fancong888/harvester/data/6-Software part/0-Original materilas/微信图片_20220603220855.jpg

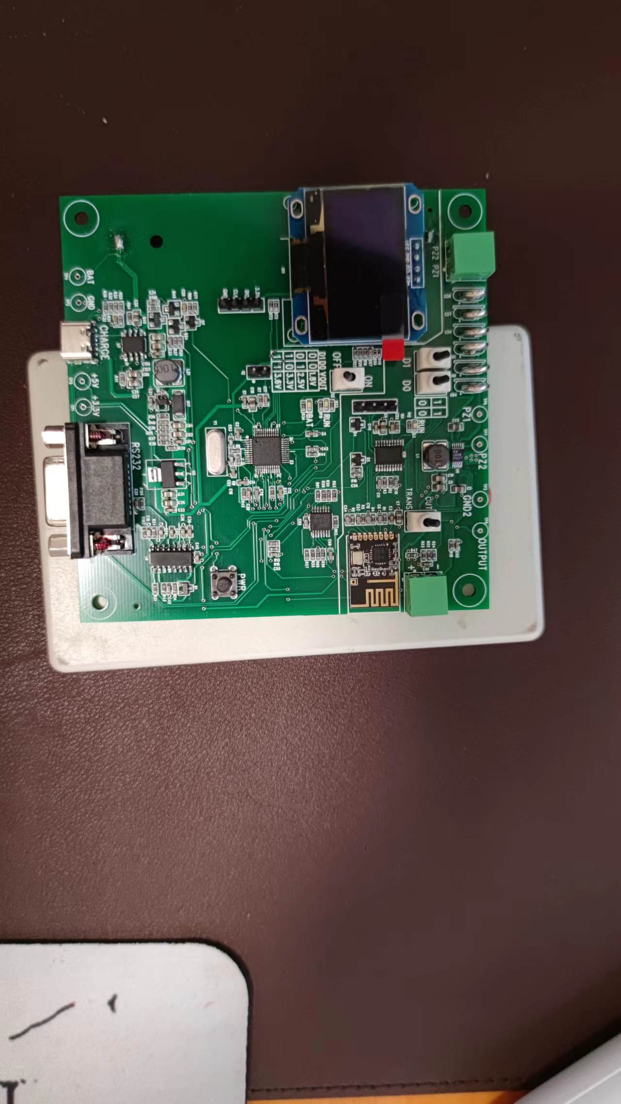
data/6-Software part/0-Original materilas/微信图片_20220603220855.jpg
