fancong888/harvester/data/Plan.pdf

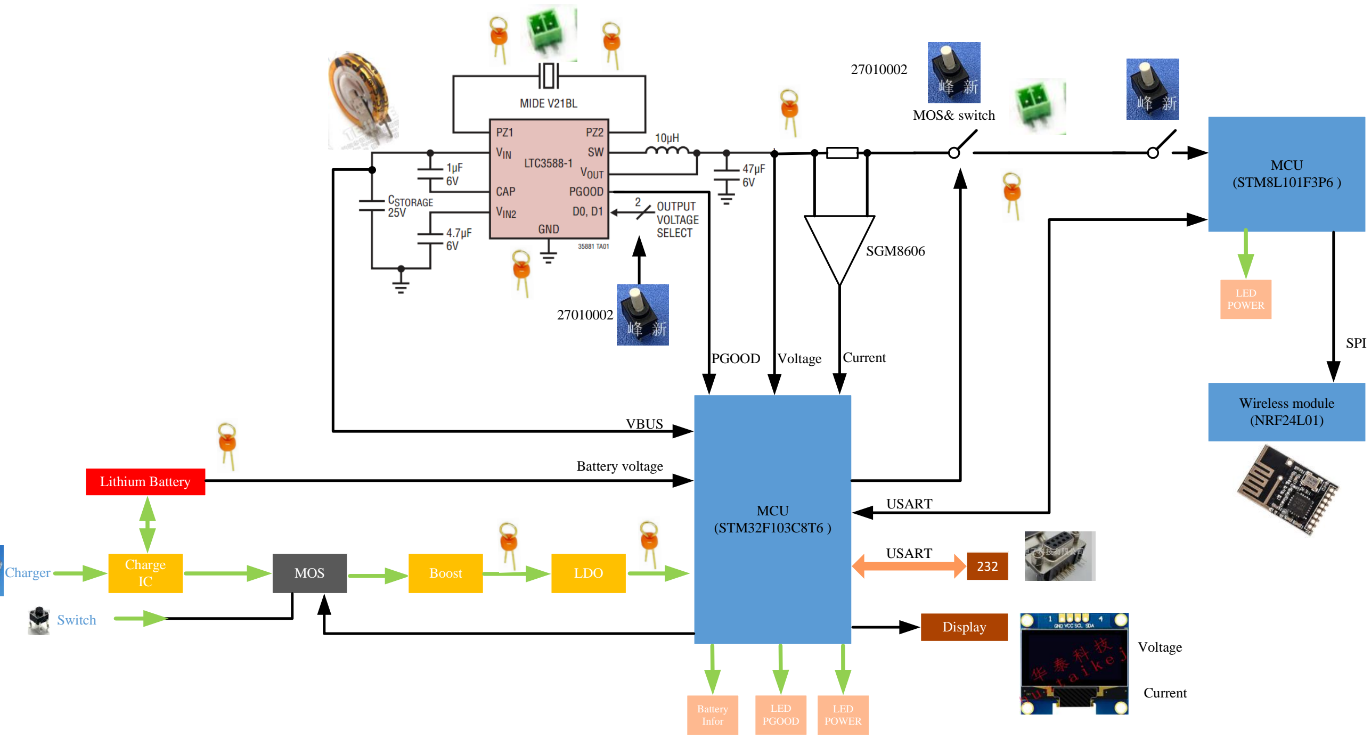
[picture p2: figure]
MCU (STM32F103C8T6 ); Charger; LED PGOOD; Lithium Battery; Charge; MOS; LDO; Switch; Boost; Display; MOS& switch; LED POWER; PGOOD; Voltage; Current; Battery voltage; Battery Infor; SGM8606; MCU (STM8L101F3P6 ); Wireless module (NRF24L01); USART; SPI; VBUS
