fancong888/harvester/data/2-Circuit diagram/Produce/2-BOM/original.xlsx

Amount | Designator ref | Description | 嘉丽创CODE | Notes
2 | R49-50 | 04020298-C-RES-1/16W-510K-1%-SR0402,510K
1 | R47 | 04020329-C-RES-0.1W-1R-1%-SR0603,1R
16 | R1-6 R9 R15-16 R18 R43-44 R57 R61 R186-187 | 04020357-C-RES-1/10W-100R-1%-SR0603,100¦¸
9 | R22 R25 R29-30 R32 R35 R37 R40 R54 | 04020389-C-RES-1/10W-22K-1%-SR0603,22K
4 | R19-20 R52-53 | 04020398-C-RES-1/10W-100K-1%-SR0603,100K
4 | R8 R11 R27 R41 | 04021009-C-RES-1/10W-5.1K-1%-SR0603,5.1k¦¸¡À1%
15 | R7 R21 R24 R33 R36 R38 R55 R58 R62-64 R69 R72-73 R198 | 04021011-C-RES-1/10W-10K-1%-SR0603,10k¦¸¡À1%
4 | R13-14 R17 R51 | 04021018-C-RES-1/10W-3.3K-1%-SR0603,3.3K¡À1%
13 | R10 R12 R23 R26 R28 R31 R34 R39 R45 R56 R59-60 R77 | 04021021-C-RES-1/10W-1K-1%-SR0603,1k¦¸¡À1%
18 | C8 C10-12 C19-21 C42-43 C53-56 C65-67 C69-70 | 05020070-C-CAP-50V-100PF-5%-NPO-SC0603,50V-100pF
8 | C3 C36-40 C49 C52 | 05020074-C-CAP-50V-0.1UF-10%-X7R-SC0603,50V-0.1¦ÌF
2 | C62-63 | 05021004-C-CAP-50V-20PF-5%-NPO-SC0603,50V-20pF
4 | C22 C30 C32-33 | 05021013-C-CAP-50V-0.1UF-10%-X7R-SC0603,0.1uF
13 | C1-2 C4 C13-14 C17-18 C29 C34 C45 C68 C81 C88 | 05021013-C-CAP-50V-0.1UF-10%-X7R-SC0603,50V-0.1¦ÌF
4 | D1 D4-5 D7 | 06010179-S-DIO-30V-200MA-BAT54CLT1G-A,30V-200mA-0.35V | C68978 | SOT-23二极管共阴极
1 | Q24 | 06020035-PNP-80V-0.5A-MMBTA56-7-F-SOT23,MMBTA56-7-F | C8326
1 | Q45 | 06021007-NPN-DYN-40V-0.6A-MMBT4401LT1G,MMBT4401LT1G | C20526
1 | Q46 | 06030094-F_E_T-30V-2.2A-NTR4171PT1G,NTR4171PT1G | C10487
3 | D2-3 D6 | 06070018-LED2-GREEN-WR-PB1608G-SD0603,WR-PB1608G-S01 | C72043
1 | D17 | 06013009-S-DIO-40V-1A-MBRA140T3G,MBRA140T3G | 有
6 | C57-61 C64 | 05060005-S-CAP-3.3V-0.22F-B,3.3V-0.22F |  | 领出来
6 | C5 C7 C9 C15 C23 C35 | 05020004-C-CAP-25V-4.7UF-10%-X7R-SC0805,25V-4.7uF |  | 领出来
10 | C6 C16 C26-28 C31 C82 C84 C125 C156 | 05020097-C-CAP-10V-22UF-20-X5R-SC0805,10V-22uF | 有
1 | U1 | 07010013-IC-STM32F103C8-QFP48,STM32F103C8 | 有
1 | U5 | 09010024-VREG-TLV1117-33IDCYR-SOT-223,TLV1117-33IDCYR | 有
1 | U6 | 09010026-VREG-MP1541DJ-TSOT23-5,MP1541DJ | 有
1 | U4 | 09030036-AMP-OPA4376AIPWR-SOP14,OPA4376AIPWR |  | 领出来
2 | L1 L21 | 11011005-L2-SMT-10UH-20,10uH¡À20% | 有
1 | J2 | 15011001-SIP2-2.54MM-3A-201K0200,201K0200 | 有
1 | CN1 | 15014007-CON9-6223-09FSNS0B01-A,6223-09FSNS0B01 |  | 领出来
2 | J4 J8 | 15020595-CON2-3.81MM-F83-7-C020350-H,F83-7-C020350 |  | 领出来
1 | U8 | 16010002-DRI-MAX202IDR-SOIC16,MAX202IDR | 有
4 | S1-4 | 27010002-SWI5-2.54MM-UT-4-T2CK-2-H,UT-4-T2CK-2-H /ºèº² /C |  | 领出来
1 | U2 | BATTERY_18650_SINGLE | Buy | ok
1 | Y1 | CRSTAL-8MHZ-C443528-DIP | 有
1 | U7 | IC-CN3051A-SOP8,M24M01-DFMN6TP | 有
1 | S5 | KEY_DIP-4PINS_C110153 | 有
1 | U9 | LTC3588EMSE-1TRPBF | Buy | ok
1 | U3 | NRF2401+_SMD | 有
1 | U11 | SCREEN_OLED_1.3INCH_DIP | 有
2 | J1 J3 | SIP4-1X4P-2.54MM-M | 有
1 | U10 | STM8L101F3P6 | Buy | ok
1 | J5 | TYPE_C_SMD_C283540 | Buy | ok
 | 压电片 |  | Buy
