fancong888/harvester/data/2-Circuit diagram/Produce/2-BOM/upload.xlsx

Comment型号 | Designator位号 | Footprint封装 | 嘉立创元件编号(可不要此列)
510K | R49-50 | 0402 | C11616
1Ω | R47 | 0603 | C22936
100Ω | R1-6 R9 R15-16 R18 R43-44 R57 R61 R186-187 | 0603 | C22775
22KΩ | R22 R25 R29-30 R32 R35 R37 R40 R54 | 0603 | C31850
100K | R19-20 R52-53 | 0603 | C25803
5.1kΩ | R8 R11 R27 R41 | 0603 | C23186
10kΩ | R7 R21 R24 R33 R36 R38 R55 R58 R62-64 R69 R72-73 R198 | 0603 | C25804
3.3KΩ | R13-14 R17 R51 | 0603 | C22978
1kΩ | R10 R12 R23 R26 R28 R31 R34 R39 R45 R56 R59-60 R77 | 0603 | C21190
100pF | C8 C10-12 C19-21 C42-43 C53-56 C65-67 C69-70 | 0603 | C14858
0.1UF | C3 C36-40 C49 C52 | 0603 | C14663
20pF | C62-63 | 0603 | C1648
0.1uF | C22 C30 C32-33 | 0603 | C14663
0.1UF | C1-2 C4 C13-14 C17-18 C29 C34 C45 C68 C81 C88 | 0603 | C14663
06010179-S-DIO-30V-200MA-BAT54CLT1G-A,30V-200mA-0.35V | D1 D4-5 D7 | SOT-23 | C68978
06020035-PNP-80V-0.5A-MMBTA56-7-F-SOT23,MMBTA56-7-F | Q24 | SOT-23 | C8326
06021007-NPN-DYN-40V-0.6A-MMBT4401LT1G,MMBT4401LT1G | Q45 | SOT-23 | C20526
06030094-F_E_T-30V-2.2A-NTR4171PT1G,NTR4171PT1G | Q46 | SOT-23 | C10487
06070018-LED2-GREEN-WR-PB1608G-SD0603,WR-PB1608G-S01 | D2-3 D6 | 0603 | C72043
