fancong888/harvester/data/4-Others/1-Battery packge design/Drawing1.dxf

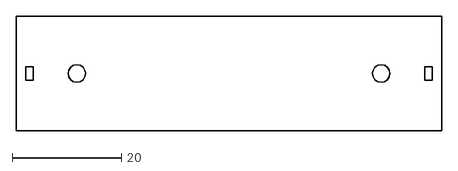
[picture p4: CAD file, 2022-07-17]
data/4-Others/1-Battery packge design/Drawing1.dxf
77.7 x 20.9
