fancong888/harvester/data/4-Others/2-OLED Screen packege/Drawing1.dxf

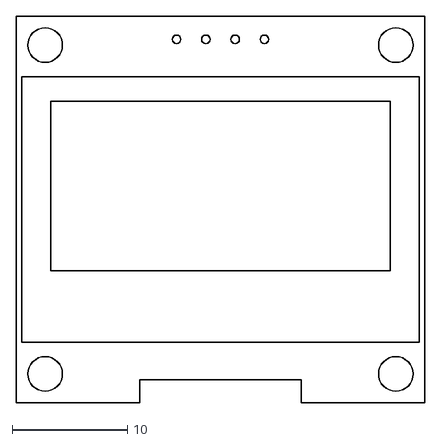
[picture p5: CAD file, 2022-07-17]
data/4-Others/2-OLED Screen packege/Drawing1.dxf
35.4 x 33.5
