fancong888/harvester/(list of files, cad)

Other CAD files:
data/4-Others/1-Battery packge design/Drawing1.dwg
data/4-Others/1-Battery packge design/Part1.CATPart
data/4-Others/2-OLED Screen packege/Drawing1.dwg
