fancong888/harvester/(list of files, drawings)

Other design files:
data/2-Circuit diagram/Energy harvester.pcb
