fancong888/harvester/code/STM32F103C8/02_Phy/PhyGpio/PhyGpio.h

#ifndef	_PHYGPIO_H_
#define _PHYGPIO_H_

/*******************************Definition***************************************/
#define PHYIO_FILTER_TIME       10   //MS
#define PHYIO_DI_NUM            4

unsigned long ul_phyIo_terminal;
unsigned char uc_phyIo_diFilter[PHYIO_DI_NUM];




/*******************************Function***************************************/



#endif
