fancong888/harvester/code/STM32F103C8/02_Phy/PhySys/PhySys.h

#ifndef	_PHYSYS_H_
#define _PHYSYS_H_

/*******************************Definition***************************************/
ErrorStatus HSEStartUpStatus;



/*******************************Function***************************************/



#endif
