fancong888/harvester/code/STM32F103C8/02_Phy/PhyGpio/Public_PhyGpio.h

#ifndef	_PUBLIC_PHYGPIO_H_
#define _PUBLIC_PHYGPIO_H_

/*******************************Definition***************************************/
union GPIO_OUTPUT
{
    unsigned short all; 	
    struct 
    {
        unsigned short powerHold: 1;                
        unsigned short runLed: 1;                        
        unsigned short batLed: 1;                        
        unsigned short rsvd1: 13;                       
    }bit;
};

union GPIO_INPUT
{
    unsigned short all; 	
    struct 
    {
        unsigned short charge: 1;
        unsigned short powerHold: 1;
        unsigned short rsvd1: 14;                       
    }bit;
};



/*******************************Function***************************************/
void PhyGpio_ParamInit(void);
void PhyGpio_PeriphInit(void);
unsigned long PhyGpio_ReadFromPeriph(void);
void PhyGpio_WriteToPeriph(union GPIO_OUTPUT *pOutput);
void PhyIo_DiDeal(void);



#endif
