fancong888/harvester/code/STM32F103C8/02_Phy/OLED_I2C/Public_OLED_I2C.h

#ifndef	_PUBLIC_OLED_I2C_H_
#define _PUBLIC_OLED_I2C_H_

/*******************************Definition***************************************/




/*******************************Function***************************************/
void PhyIIC_OLEDInit (void);
bool OLED_ShowStr1(unsigned char x, unsigned char y, char ch[]);




#endif
