fancong888/harvester/code/STM32F103C8/02_Phy/PhyAdc/Public_PhyAdc.h

#ifndef	_PUBLIC_PHYADC_H_
#define _PUBLIC_PHYADC_H_

/*******************************Definition***************************************/





/*******************************Function***************************************/
void PhyAdc_Init(void);
unsigned short PhyAdc_GetValue(unsigned short us_num);




#endif
