fancong888/harvester/code/STM32F103C8/03_Obj/ObjSci/Public_ObjSci.h

#ifndef	_PUBLIC_OBJSCI_H_
#define _PUBLIC_OBJSCI_H_

/*******************************Definition***************************************/




/*******************************Function***************************************/
void ObjSci_Uart1MainDeal(void);
void ObjSci_Uart2MainDeal(void);




#endif
