fancong888/harvester/(commit log)

2022-07-17 初版文件
    [Coordinate.xlsx, Coordinate1.xlsx, Drawing1.dwg, Drawing1.dxf, Energy harvester.pcb, Energy harvester.sch, Part1.CATPart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]
2022-07-17 1.加入电池充电检测 2.OLED滤波处理
2022-07-17 删除无效文件
2022-07-17 上传烧录文件
2022-07-18 显示优化
2022-08-24 1.电源保持按键更改 2.ADC采样更新
